ducdung3907/ai-rtl/README.md

# ai-rtl: int8 Systolic Array Matrix Multiplier



A parameterised **N×N output-stationary systolic array** in SystemVerilog that computes **C = A × B** on signed 8-bit inputs with 32-bit accumulators, the core operation of neural-network accelerators such as Google's TPU.

You feed plain matrices one column of A and one row of B per cycle; the hardware skews the inputs, streams them through N² multiply-accumulate units, and raises `done` the cycle the result is ready. Two MAC designs are selectable with one parameter: a single-cycle MAC built from logic, and a two-stage pipelined MAC that maps onto one DSP48E1 per PE.

On an AMD Artix-7 the pipelined array holds **above 220 MHz up to N = 15** (225 PEs, about **99 GOPS** peak) while using **under 150 LUTs**, compared with 114 MHz and 33,371 LUTs for the single-cycle version at N = 16. Everything is verified in simulation for N = 2 to 8 with random data, varying matrix lengths, idle cycles in the input stream and back-to-back matrices, for both MAC designs.

The array runs on an **FPGA board** (QMTech Wukong V3, XC7A100T) in two designs:

- **v2, matrix-multiply server:** a PC sends A and B over USB-UART and gets C back. Measured on the board: every result correct, up to 336 jobs/s with jobs overlapped, and an int8 MNIST network bit-exact on 1,000 images with all its multiply-accumulates on the array.
- **v3, the whole network on the chip:** the weights live in block RAM and the FPGA runs both layers, bias, requantisation, ReLU and argmax; the PC sends 4 images and gets 4 digits back. Measured on the board: 8.9 ms per image (33× faster than v2), every digit identical to the integer reference, 97.20% on the 10,000 test images.

All 44 testbench runs execute on every push through GitHub Actions.

## Block diagram

```mermaid
flowchart LR
    A["a_col<br/>(column of A)"] --> SA["skew_a<br/>row i delayed i cycles"]
    B["b_row<br/>(row of B)"] --> SB["skew_b<br/>column j delayed j cycles"]
    V["valid / start"] --> SA
    V --> SB
    SA -- "a, valid, clear" --> ARR["N×N systolic array<br/>(N² PEs)"]
    SB -- "b, valid" --> ARR
    ARR --> C["acc[i][j] = C[i][j]"]
    L["last"] --> D["delay line<br/>2(N−1) + MAC_LAT cycles"] --> DONE["done"]
```

Inside the array, `a` values move right and `b` values move down, one PE per cycle. Each PE multiplies the pair passing through it and keeps its own running sum:

```
            b[0]       b[1]       b[2]       b[3]
             ▼          ▼          ▼          ▼
a[0] ──►  PE(0,0) ──► PE(0,1) ──► PE(0,2) ──► PE(0,3)
             ▼          ▼          ▼          ▼
a[1] ──►  PE(1,0) ──► PE(1,1) ──► PE(1,2) ──► PE(1,3)
             ▼          ▼          ▼          ▼
a[2] ──►  PE(2,0) ──► PE(2,1) ──► PE(2,2) ──► PE(2,3)
             ▼          ▼          ▼          ▼
a[3] ──►  PE(3,0) ──► PE(3,1) ──► PE(3,2) ──► PE(3,3)

PE(i,j) accumulates C[i][j] = Σk A[i][k] · B[k][j]
```

## Features

- **Parameterised size N** (tested N = 2, 3, 4, 8), built with `generate` loops
- **Two MAC designs, one parameter:** `MAC_LAT = 1` (single-cycle) or `MAC_LAT = 2` (pipelined, one DSP48 per PE); the `done` timing follows automatically
- **Any inner dimension K:** an N×N array computes (N×K) × (K×N) for any K; the 32-bit accumulator has headroom for very long sums
- **Signed int8 × int8 → int32** multiply-accumulate in every PE
- **Hardware input skewing:** the array takes unskewed columns and rows straight from memory
- **Valid signals travel with the data:** idle cycles (bubbles) anywhere in the input are ignored
- **Per-row clear travelling with the data:** matrices can be streamed back to back with no gap
- **`done` signal:** pulses exactly 2(N−1) + MAC_LAT cycles after the last column, on the first cycle all results are final
- **Area-aware registers:** control signals (valid, start, done) have a reset; data registers (skew lanes, forwarded `a` and `b`) do not, since their valid bit marks them as unused

## Top-level interface: `complete_sa`

| Parameter | Default | Description |
| --- | --- | --- |
| `N` | 4 | Array size (N×N PEs) |
| `MAC_LAT` | 2 | MAC latency in cycles: 1 = single-cycle `mac8`, 2 = pipelined `mac8_pipe` |

| Port | Dir | Width | Description |
| --- | --- | --- | --- |
| `clk` | in | 1 | Clock |
| `rst_n` | in | 1 | Reset, active low (hold for at least one clock edge: the pipelined MAC resets synchronously) |
| `a_col` | in | `[N-1:0][7:0]` | Column k of A: `a_col[i] = A[i][k]` |
| `b_row` | in | `[N-1:0][7:0]` | Row k of B: `b_row[j] = B[k][j]` |
| `valid` | in | 1 | This cycle's column/row is real data |
| `start` | in | 1 | First column of a new matrix (starts fresh sums) |
| `last` | in | 1 | Last column of the matrix |
| `done` | out | 1 | One-cycle pulse when every result is final |
| `acc` | out | `[N-1:0][N-1:0][31:0]` | `acc[i][j] = C[i][j]` (signed) |

**Usage:** on each cycle, drive one column of A and the matching row of B with `valid = 1`. Set `start = 1` on the first column and `last = 1` on the last (both on the same cycle if K = 1). Wait for `done`, then read `acc`.

## How it works

**Dataflow (output-stationary).** Each PE keeps one element of C. Row i of A enters from the left and moves right; column j of B enters from the top and moves down. Every PE forwards its inputs to its neighbours through registers, one cycle per hop.

**Skewing.** Data reaching PE(i,j) has passed through j PEs horizontally and i PEs vertically, so the `a` and `b` paths have different delays. To line them up, row i of A enters i cycles late and column j of B enters j cycles late. Both then reach PE(i,j) after i + j cycles, so the k-th product happens on cycle **k + i + j**. The skew module implements this with shift registers: lane i has exactly i registers, N(N−1)/2 per side.

For N = 2, the inputs reaching the array look like this:

| Cycle | Row 0 | Row 1 | Column 0 | Column 1 |
| --- | --- | --- | --- | --- |
| 0 | A00 | – | B00 | – |
| 1 | A01 | A10 | B10 | B01 |
| 2 | – | A11 | – | B11 |

**Valid and clear.** Each value carries a valid bit; a PE only accumulates when both its inputs are valid, so empty slots in the skew pattern and idle cycles in the input are ignored. The `start` signal is skewed into one clear per row and travels right with `a`, so it reaches PE(i,j) exactly when that PE's first product of a new matrix arrives (clear-and-load in one cycle). A single global clear would instead force a pause between matrices.

**Timing.** For a matrix with K columns fed on cycles 0 … K−1:

| Quantity | Value |
| --- | --- |
| `done` after the last column | 2(N−1) + MAC_LAT cycles = (N−1) skew + (N−1) PE hops + MAC latency |
| First column to `done` | K + 2(N−1) + MAC_LAT − 1 cycles |
| Peak throughput | N² multiply-accumulates per cycle (both MAC designs) |

The pipelined MAC adds its extra cycle **once**, not once per PE: `a` and `b` reach the next PE through the PE's forwarding registers, not through the MAC, so the MAC's latency only delays each PE's own result.

## The two MACs

**`mac8` (MAC_LAT = 1):** multiply and accumulate in one cycle. Simple, but the critical path is input register → 8×8 multiplier → 32-bit adder at every array size.

**`mac8_pipe` (MAC_LAT = 2):** two stages, written so Vivado maps the whole MAC into one DSP48E1 (product in the M register, sum in the P register):

1. **Stage 1:** `prod <= a × b`, or **0** when the input is invalid or in reset. `clear1` is the clear delayed by one cycle.
2. **Stage 2:** `acc <= prod` when `clear1` is set, otherwise `acc <= acc + prod`.

Forcing invalid products to zero collapses the four cases (load, clear, add, hold) into two (load or add), since adding 0 is the same as holding. Stage 2 therefore depends on a single register bit, `clear1`, which drives the DSP's OPMODE pin with no logic in between. All resets are synchronous, as the DSP's internal registers require, and `clear1` carries a `keep` attribute so synthesis keeps one copy per PE (see the timing results below).

## Modules

| File | Module | Description |
| --- | --- | --- |
| [`rtl/mac.sv`](rtl/mac.sv) | `mac8`, `mac8_pipe` | Single-cycle MAC, and the two-stage pipelined MAC for DSP48 mapping |
| [`rtl/pe.sv`](rtl/pe.sv) | `pe8` | Processing element: selects the MAC with `MAC_LAT`, plus registers that forward a, b, valid and clear |
| [`rtl/sa2x2.sv`](rtl/sa2x2.sv) | `sa2x2` | 2×2 array wired by hand (first step towards N×N) |
| [`rtl/saNxN.sv`](rtl/saNxN.sv) | `systolic_array` | Parameterised N×N array built with nested `generate` loops |
| [`rtl/skew.sv`](rtl/skew.sv) | `skew` | Input skewing: lane i delayed by i cycles, with valid and start |
| [`rtl/sa_top.sv`](rtl/sa_top.sv) | `complete_sa` | Top level: two skew modules, the array and the `done` delay line |
| [`board/uart_rx.sv`](board/uart_rx.sv) | `uart_rx` | 8N1 receiver: 2-flop synchroniser, mid-bit sampling, false-start and framing-error rejection, 1-clock `valid` |
| [`board/uart_tx.sv`](board/uart_tx.sv) | `uart_tx` | 8N1 transmitter with valid/ready handshake; accepts the next byte in the last stop-bit clock, so frames follow with no gap |
| [`board/sa_ctrl.sv`](board/sa_ctrl.sv) | `sa_ctrl` | Job controller (v2): reads request bytes from the FIFO, feeds `complete_sa` one step per K, hands the result to `res_buf` on `done` |
| [`board/sync_fifo.sv`](board/sync_fifo.sv) | `sync_fifo` | First-word-fall-through byte FIFO between `uart_rx` and `sa_ctrl`, with a sticky overflow flag |
| [`board/res_buf.sv`](board/res_buf.sv) | `res_buf` | Result buffer: captures `acc`, then streams the N×N int32 bytes to `uart_tx` while the next job already computes |
| [`board/sa_board_top.sv`](board/sa_board_top.sv) | `sa_board_top` | Board top: reset synchroniser, UART, FIFO, `sa_ctrl`, `complete_sa`, `res_buf`, heartbeat and job LEDs (`led[0]` solid = FIFO overflow) |
| [`board/frame_rx.sv`](board/frame_rx.sv) | `frame_rx` | v3 frame parser: START, seq, 3,136 pixel bytes, checksum; writes 4 bytes per word into the input RAM, pulses `frame_ok` / `frame_err`, resyncs on any top-bit byte |
| [`board/infer_core.sv`](board/infer_core.sv) | `infer_core` | v3 controller and datapath: input, hidden and weight memories, `complete_sa`, 4 requant lanes, 4 argmax units; runs both layers tile by tile |
| [`board/requant.sv`](board/requant.sv) | `requant` | Bias add, fixed-point scale (`× M >> shift`, rounded) and clip to 0..127 (the ReLU); 3-stage pipeline |
| [`board/argmax.sv`](board/argmax.sv) | `argmax` | Index of the largest of `WIDTH` values streamed one per cycle; the first maximum wins a tie |
| [`board/simple_dp_ram.sv`](board/simple_dp_ram.sv) | `simple_dp_ram` | One write port and one read port, 1-cycle read (block RAM) |
| [`board/weight_rom.sv`](board/weight_rom.sv) | `weight_rom` | Block-RAM ROM loaded from a `.mem` file (weights, biases) |
| [`board/reply_tx.sv`](board/reply_tx.sv) | `reply_tx` | v3 reply: `[A6][seq][4 digits]` or `[E6][seq]` on a checksum error, one byte at a time to `uart_tx` |
| [`board/infer_board_top.sv`](board/infer_board_top.sv) | `infer_board_top` | v3 board top: `uart_rx → frame_rx → infer_core → reply_tx → uart_tx`; same pins as `sa_board_top` |
| [`board/board_top.sv`](board/board_top.sv) | `board_top` | Bring-up design: UART echo with a pending flag, heartbeat and byte LEDs |
| [`board/wukong.xdc`](board/wukong.xdc), [`board/wukong_impl.xdc`](board/wukong_impl.xdc) | | Pin and clock constraints from the QMTECH Wukong V3 schematic (the second file is implementation-only) |
| [`host/run_jobs.py`](host/run_jobs.py) | | Python host: echo test, single job, 1,000-job run with throughput report, and a software model of the board |
| [`host/infer_frame.py`](host/infer_frame.py) | | v3 frame protocol: builds frames, parses replies, and a byte-level software model of the board (`FakeInferBoard`) |

## Verification

Every testbench is self-checking: it computes the expected result with a reference model in the testbench and prints PASS or FAIL. `sim/run_all.sh` runs all of them across sizes and settings (44 runs) and fails if any run fails; GitHub Actions runs it on every push. Results with Icarus Verilog 12 (local and CI); also checked with 14.0 devel:

| Testbench | Covers | Result |
| --- | --- | --- |
| [`tb/tb_mac.sv`](tb/tb_mac.sv) | Both MACs against one reference model: reset with inputs active, 13 directed cases, 20,000 weighted-random cycles, coverage counters | PASS (20,018 checks) |
| [`tb/tb_pe.sv`](tb/tb_pe.sv) | Reset, forwarding, valid gating, directed cases, 20,000 random cycles; reference model delayed by the MAC latency | PASS for MAC_LAT = 1 and 2 (20,014 / 20,015 checks) |
| [`tb/tb_sa2x2.sv`](tb/tb_sa2x2.sv) | 6 directed matrices + 1,000 random, skew done in the testbench | PASS (1,006 multiplications) |
| [`tb/tb_asNxN.sv`](tb/tb_asNxN.sv) | Identity, K = 1, extreme values, back-to-back, 500 random with varying K | PASS at N = 2, 3, 4, 8 (555 multiplications each) |
| [`tb/tb_skew.sv`](tb/tb_skew.sv) | Input-history model; reset with inputs active, impulse, counting pattern, all-bits toggle, 2,000 random cycles | PASS at N = 1 to 64 (32,737 checks at N = 8) |
| [`tb/tb_sa_top.sv`](tb/tb_sa_top.sv) | Full chain from unskewed input: directed, bubbles with junk data, back-to-back, 500 random; exact `done` timing | PASS at N = 2, 3, 4, 8 for MAC_LAT = 1 and 2 (605 multiplications each) |
| [`tb/tb_uart_tx.sv`](tb/tb_uart_tx.sv) | Receiver model and queue scoreboard; every bit exactly one bit time, `ready` timing, back-to-back frames | PASS (316 bytes) |
| [`tb/tb_uart_rx.sv`](tb/tb_uart_rx.sv) | Asynchronous sender at ±2.5% baud error, glitches, bad stop bits, back-to-back, random gaps | PASS (238 bytes; glitches and bad frames ignored) |
| [`tb/tb_board_top.sv`](tb/tb_board_top.sv) | Echo through the pins, continuous streams with the PC 0.5% fast and slow, LEDs | PASS (53 bytes each) |
| [`tb/tb_sa_ctrl.sv`](tb/tb_sa_ctrl.sv) | Controller with the real `complete_sa`: K = 0, 1, N, 7, 256 and random, junk before the header, `tx_ready` backpressure, bytes during compute ignored | PASS at N = 2, 4, 8 for MAC_LAT = 1 and 2 (25 jobs each) |
| [`tb/tb_sa_board_top.sv`](tb/tb_sa_board_top.sv) | Whole board path: a PC model sends jobs bit by bit into the `uart_rx` pin and checks C from the `uart_tx` pin | PASS (12 jobs; also at PC baud ±0.5%) |
| [`tb/tb_requant.sv`](tb/tb_requant.sv) | 5,614 vectors from [`tb/gen_requant_vectors.py`](tb/gen_requant_vectors.py): rounding, negative sums (ReLU), saturation, back to back | PASS |
| [`tb/tb_argmax.sv`](tb/tb_argmax.sv) | Directed, random, ties (first maximum), gaps, junk while `in_valid` is low; exact 1-cycle timing | PASS for WIDTH = 10 and 4 (1,510 vectors) |
| [`tb/tb_simple_dp_ram.sv`](tb/tb_simple_dp_ram.sv), [`tb/tb_weight_rom.sv`](tb/tb_weight_rom.sv) | 1-cycle read, read-first on a same-address write, write enable; ROM contents against `ml/mem/weights.mem` | PASS |
| [`tb/tb_frame_rx.sv`](tb/tb_frame_rx.sv) | Good frames, bad checksums (every checksum bit), dropped and extra bytes, stray START, truncated frames, 60 fuzzed frames | PASS at N_STEPS = 784 and 16 |
| [`tb/tb_infer_core.sv`](tb/tb_infer_core.sv) | 15 batches (60 images) from [`tb/gen_infer_vectors.py`](tb/gen_infer_vectors.py): digits, all 64 hidden words, `done_seq`, one `done` pulse, `busy`, a second `start` ignored | PASS (12,991 cycles per batch) |
| [`tb/tb_reply_tx.sv`](tb/tb_reply_tx.sv) | Random done/error events, both at once, events during a reply, `tx_ready` 100/50/10% | PASS |
| [`tb/tb_infer_board_top.sv`](tb/tb_infer_board_top.sv) | v3 through the UART pins: junk, good frames, bad checksum, cut frames, seq 0 and 127, LEDs | PASS (6 replies) |

Each testbench was also checked against deliberately broken designs (wrong wiring, missing reset, misaligned valid, clear not travelling with the data, `done` one cycle late, and for the pipelined MAC: using `clear` instead of `clear1`, a stuck valid, a product register without reset) to make sure it catches real bugs.

## Running the tests

Requires [Icarus Verilog](https://steveicarus.github.io/iverilog/) 12 or newer. From the repository root, run everything (runs in parallel, `JOBS=1` for one at a time; the two v3 system runs take about 1 and 4 minutes on their own):

```bash
./sim/run_all.sh            # all 44 runs, exits 1 if any fails
./sim/run_all.sh sa_ctrl    # only runs whose name contains "sa_ctrl"
```

Or single testbenches:

```bash
# Full system (skew + array + done), pipelined MAC
iverilog -g2012 -Ptb_complete_sa.MAC_LAT=2 -o sim.vvp rtl/mac.sv rtl/pe.sv rtl/saNxN.sv rtl/skew.sv rtl/sa_top.sv tb/tb_sa_top.sv
vvp sim.vvp

# Individual blocks
iverilog -g2012 -o sim.vvp rtl/mac.sv tb/tb_mac.sv && vvp sim.vvp
iverilog -g2012 -Ptb_pe8.MAC_LAT=2 -o sim.vvp rtl/mac.sv rtl/pe.sv tb/tb_pe.sv && vvp sim.vvp
iverilog -g2012 -o sim.vvp rtl/mac.sv rtl/pe.sv rtl/sa2x2.sv tb/tb_sa2x2.sv && vvp sim.vvp
iverilog -g2012 -o sim.vvp rtl/mac.sv rtl/pe.sv rtl/saNxN.sv tb/tb_asNxN.sv && vvp sim.vvp
iverilog -g2012 -o sim.vvp rtl/skew.sv tb/tb_skew.sv && vvp sim.vvp
```

Other sizes, MAC designs and random seeds:

```bash
iverilog -g2012 -Ptb_complete_sa.N=8 -Ptb_complete_sa.MAC_LAT=1 -o sim.vvp rtl/*.sv tb/tb_sa_top.sv
vvp sim.vvp +seed=42
```

## On the board: UART host interface

```
PC ──USB── CH340 ──> uart_rx ──> sync_fifo ──> sa_ctrl ──> complete_sa ──> res_buf ──> uart_tx ──> CH340 ──> PC
```

**Protocol (PC → FPGA):** header `0xA5`, then K (number of steps, 2 bytes little-endian, 1 to 65,535; K = 0 means no job), then K steps of 2N bytes: column k of A followed by row k of B, signed int8. **Reply:** the N×N results row by row, each a little-endian int32 (64 bytes at N = 4). `res_buf` takes the snapshot of `acc` once the array is done, so the reply is correct even while the next request streams in.

**Board:** QMTECH Wukong V3 (XC7A100T-1FGG676C, 50 MHz oscillator, CH340 USB-UART). Pins and the configuration-bank settings come from the V3 schematic; the 50 MHz clock arrives on a non-clock-capable pin, which `wukong_impl.xdc` allows. The echo design uses 79 LUTs and 86 flip-flops (matching a hand count of every register) and meets timing at 50 MHz with 15.7 ns of slack.

**Host script:**

```bash
python host/run_jobs.py --mode echo --port COM5                 # with the board_top (echo) bitstream
python host/run_jobs.py --mode job  --port COM5 --N 4 --K 16    # one job, compared with NumPy
python host/run_jobs.py --mode run  --port COM5 --jobs 1000     # 1,000 random jobs, jobs/s and throughput
python host/run_jobs.py --mode run  --port fake                 # no board: software model of sa_ctrl
```

**Expected throughput:** 1,000 jobs with K up to 64 move about 325 KB. At 115,200 baud the UART carries at most 11,520 bytes/s, so the run takes at least about 28 s (about 35 jobs/s), while the array computes each job in about a microsecond. The link, not the array, sets the speed.

**Measured on the Wukong board** (N = 4, MAC_LAT = 2, 50 MHz, random jobs checked against NumPy):

| Baud | Jobs | Result | Jobs/s | Throughput | Share of link limit |
| --- | --- | --- | --- | --- | --- |
| 115,200 | 1,000 (K ≤ 64) | 1000/1000 correct | 34.6 | 11,242 B/s | 97.6% |
| 1,000,000 | 1,000 (K ≤ 64) | 1000/1000 correct | 236.3 | 76,809 B/s | 76.8% |
| 1,000,000 | 100 (K ≤ 1000) | 100/100 correct | 21.2 | 88,535 B/s | 88.5% |
| 2,000,000 | — | replies lose one byte near byte 35 | — | — | — |

The array computes a job in about a microsecond; all of the time is data movement.

- **Where the 1 Mbaud overhead goes:** about 9% is idle gaps the CH340 USB-UART bridge leaves in the
  PC → FPGA stream (sending is ~10% slower than the ideal wire time), and about 0.6 ms per job is USB
  round-trip latency on the reply. Host-side Python adds under 1% (preparing all jobs in advance
  changed throughput by less than 1%).
- **2 Mbaud:** the FPGA receives correctly, but continuous 2 Mbaud replies overflow the CH340's
  internal buffer after about 32 bytes, so **1 Mbaud is the default**.
- **Echo stream limit:** the CH340 runs ~0.3% fast, so a continuous echo of more than ~280 bytes
  eventually drops a byte (the transmitter cannot outpace a faster sender forever). Request/reply
  jobs are not affected.

### Pipelined v2 on the board

The v2 bitstream (UART → FIFO → controller → array → result buffer → UART) built in Vivado 2025.2 for `xc7a100tfgg676-1` at 50 MHz: 681 LUTs, 192 LUTRAM, 936 flip-flops, 16 DSPs, WNS +11.730 ns, WHS +0.049 ns, 0.111 W (estimated). Same random jobs as above, N = 4, 1 Mbaud, every result checked against NumPy; `--window W` keeps W jobs in flight:

| Run | Jobs | Result | Jobs/s | Throughput |
| --- | --- | --- | --- | --- |
| window 1, K ≤ 64 | 1,000 | 1000/1000 correct | 236.6 | 76,900 B/s |
| window 2, K ≤ 64 | 1,000 | 1000/1000 correct | 330.3 (+40%) | 107,354 B/s |
| window 3, K ≤ 64 | 1,000 | 1000/1000 correct | 336.4 (+42%) | 109,359 B/s |
| window 2, K ≤ 1000 | 100 | 100/100 correct | 21.55 | 89,978 B/s |

- **The overlap works:** with window ≥ 2 the next request streams in while the previous reply goes out, so the combined rate passes the 100 KB/s single-direction limit (UART is full duplex).
- **What limits it now:** the PC → FPGA direction. A job averages 261 request bytes, so at most about 383 jobs/s; window 3 reaches about 88% of that. The remainder is the idle time the CH340 leaves between bytes.
- **Large K gains little:** a K = 500 job is about 4 KB in and 64 bytes out, so there is almost no reply to hide.
- **Window 1 is unchanged from v1** (236.6 vs 236.3 jobs/s), so the extra FIFO and buffer cost nothing when unused.
- **On-chip MNIST:** [`ml/`](ml/) runs an int8 MLP with all multiply-accumulates on the array; 1,000 validation images are bit-exact against the integer reference.

### v3: the whole network on the FPGA

In v2 the weights crossed the UART on every job and the PC did everything except the multiplies (294 ms per image). v3 keeps the weights in block RAM and runs the whole 784 → 64 → 10 network on the chip. The PC sends 4 images and reads back 4 digits.

```mermaid
flowchart LR
    RX["uart_rx"] --> FR["frame_rx<br/>parse, checksum"]
    FR --> IN["input RAM<br/>784 × 32"]
    IN --> MUX{"a_col mux"}
    HID["hidden RAM<br/>64 × 32"] -- "pass 2" --> MUX
    ROM["weight ROM<br/>12,736 × 32"] --> SA["complete_sa<br/>4×4 array"]
    MUX --> SA
    SA -- "pass 1" --> RQ["+bias1, requant ×4<br/>(ReLU)"] --> HID
    SA -- "pass 2" --> AM["+bias2, argmax ×4"] --> RP["reply_tx"] --> TX["uart_tx"]
    FR -- "frame_err" --> RP
```

**How it works.** One array runs both layers. A tile is 4 neurons (the array's 4 columns) for 4 images (its 4 rows): layer 1 is 16 tiles of 784 steps, layer 2 is 3 tiles of 64 steps (10 outputs padded to 12; the 2 padding neurons never reach the argmax). After each tile, the epilogue adds the bias to one column per cycle and either requantises it into the hidden RAM (layer 1) or feeds it to the argmax units (layer 2). Pass 2 reads the hidden RAM exactly the way pass 1 reads the input RAM. Every memory word holds 4 int8 values, one per image or one per weight column, so one read feeds all 4 lanes. One batch takes 12,991 cycles (0.26 ms at 50 MHz).

**Protocol.** PC → FPGA: `[0xA6][seq][3,136 pixel bytes][checksum]`, pixels 0..127 in step order (pixel k of images 0..3, then pixel k + 1), checksum = sum of the pixel bytes mod 128. FPGA → PC: `[0xA6][seq][d0][d1][d2][d3]`, or `[0xE6][seq]` on a checksum error. Only START has its top bit set, so a dropped or extra byte abandons that frame and the next START resyncs. The host waits for each reply before the next frame (layer 1 re-reads the input RAM on every tile).

**Weights.** [`ml/gen_mem.py`](ml/gen_mem.py) turns `mlp_64_int8.npz` into `ml/mem/weights.mem`, `bias1.mem`, `bias2.mem` and `model_params.svh` (M, shift, tile counts). In Vivado, add those four files to the project (the `.svh` as a Verilog Header).

**Vivado 2025.2 (`infer_board_top`, xc7a100tfgg676-1, 50 MHz):** 780 LUTs (all logic, no LUTRAM; v2 used 192 for its FIFO), 852 flip-flops, 24 DSPs (16 for the array, 2 per requant lane), 17.5 block RAM tiles (about 13 of them the weight ROM), WNS +12.256 ns, WHS +0.035 ns, 0.124 W (estimated). The design fills about 1% of the chip.

| Block | LUTs | Flip-flops | Block RAM | DSPs |
| --- | --- | --- | --- | --- |
| `infer_core` (controller, array, requant, argmax, memories) | 627 | 634 | 17.5 | 24 |
| `frame_rx` | 44 | 104 | 0 | 0 |
| UARTs, `reply_tx`, LEDs, reset | 109 | 114 | 0 | 0 |
| **Total** | **780** | **852** | **17.5** | **24** |

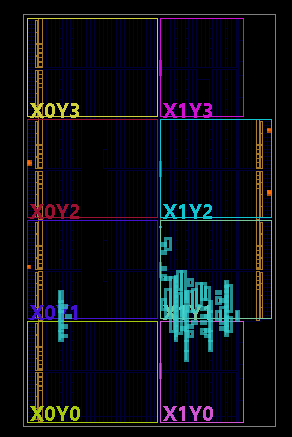
[picture p1: docs/vivado_v3_device.png]
Placed v3 design on the XC7A100T: everything sits in one corner of the chip


**Measured on the board** (`python ml/board_infer.py --onchip --port COM6`):

| Run | Images | Digits equal to `ref_infer` | Accuracy | ms per image | Images/s |
| --- | --- | --- | --- | --- | --- |
| validation | 1,000 | 1,000 of 1,000 | 97.60% | 8.91 | 112.3 |
| test | 10,000 | 10,000 of 10,000 | 97.20% | 8.90 | 112.4 |

- **Speed-up over v2:** 33× (294 ms per image in v2). 2,750 frames ran with no checksum errors or retries.
- **Traffic:** about 785 bytes per image in and 1.5 out, against 25.8 KB per image in v2.
- **The UART still sets the speed.** A frame is 3,139 bytes, so 1 Mbaud allows at best 31.4 ms per frame (7.85 ms per image). Measured: 35.6 ms per frame, 88% of that limit. The rest is the idle gaps the CH340 leaves between bytes (about 3 ms) and the USB round trip of each reply (about 1 ms); the FPGA computes a frame in 0.26 ms.
- **Against a PC:** the same network in NumPy takes about 46 µs per image (integer maths) or 1.5 µs (float32 BLAS), batched, on a 2-core cloud machine. The FPGA computes in 65 µs per image with 16 PEs at 50 MHz, using about 1% of the chip; the link, not the array, makes it slower end to end.

```
$ python ml/board_infer.py --onchip --port COM6 --n 1000
1000 images in 8.91 s: 8.91 ms/image, 112.3 images/s (250 frames, 0 retries)
UART: 784750 bytes out, 1500 bytes in (785 + 1.5 bytes/image)
board accuracy on these 1000 images: 97.60%
all 1000 digits identical to ref_infer

$ python ml/board_infer.py --onchip --port COM6 --test
10000 images in 88.97 s: 8.90 ms/image, 112.4 images/s (2500 frames, 0 retries)
UART: 7847500 bytes out, 15000 bytes in (785 + 1.5 bytes/image)
board accuracy on these 10000 images: 97.20%
all 10000 digits identical to ref_infer
```

**Drawing demo.** [`ml/draw_demo.py`](ml/draw_demo.py) lets you draw a digit with the mouse; it is turned into a 28×28 MNIST-style image and sent to the board as a frame, and the board's digit is shown next to the PC's reference scores (one answer in about 35 ms). The board and the PC agreed on every drawing; the model itself misreads some hand-drawn styles, since it is a small MLP trained only on MNIST. In the screenshot, a 9 with a curled loop is read as 3 by both.

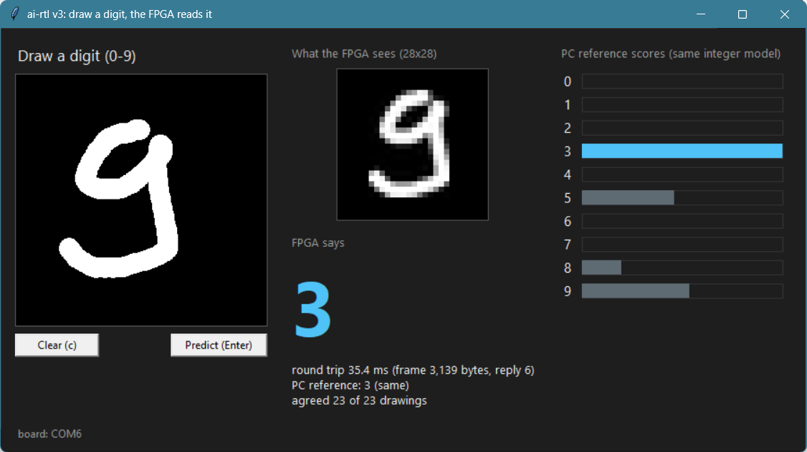
[picture p2: docs/v3_demo.png]
Drawing demo on the board: a curled 9 read as 3, the same answer as the PC's reference, 35 ms round trip


## Synthesis results

The same RTL was synthesised, placed and routed for two FPGAs with two toolflows: **AMD Artix-7** with **Vivado**, and **Lattice ECP5** with the open-source **sv2v + Yosys + nextpnr** flow. Max clock comes from static timing analysis after place and route. Peak throughput = 2 operations (multiply + add) × N² PEs × max clock.

**Summary (Artix-7 XC7A100T):**

| N | PEs | Single-cycle MAC (LUTs) | Pipelined MAC (DSP48) |
| --- | --- | --- | --- |
| 2 | 4 | 530 LUTs, 128 MHz, 1.0 GOPS | 6 LUTs + 4 DSPs, 297 MHz, 2.4 GOPS |
| 4 | 16 | 2,098 LUTs, 122 MHz, 3.9 GOPS | 11 LUTs + 16 DSPs, 282 MHz, 9.0 GOPS |
| 8 | 64 | 8,424 LUTs, 121 MHz, 15.5 GOPS | 47 LUTs + 64 DSPs, 256 MHz, 32.8 GOPS |
| 12 | 144 | 18,821 LUTs, 117 MHz, 33.7 GOPS | 102 LUTs + 144 DSPs, 233 MHz, 67.0 GOPS |
| 15 | 225 | – | 147 LUTs + 225 DSPs, 221 MHz, 99.4 GOPS |
| 16 | 256 | 33,371 LUTs, 114 MHz, 58.3 GOPS | 1,685 LUTs + 240 DSPs, 189 MHz, 96.8 GOPS |

### AMD Artix-7 (Vivado)

Target: **XC7A100T-1CSG324** (63,400 LUTs, 126,800 flip-flops, 240 DSP48E1 slices), the FPGA on the Nexys A7-100T and Arty A7-100T boards. `complete_sa` was synthesised out of context (`-mode out_of_context`, so its ports need no FPGA pins) with Vivado's default synthesis and implementation strategies and a 5 ns clock constraint ([`synth/timing.xdc`](synth/timing.xdc)); the maximum clock is 1 / (5 ns − WNS).

#### Single-cycle MAC (`MAC_LAT = 1`, LUT multipliers)

| N | PEs | LUTs | % of chip | LUTRAM | Flip-flops | DSPs | WNS at 5 ns | Max clock | Power (est.) |
| --- | --- | --- | --- | --- | --- | --- | --- | --- | --- |
| 2 | 4 | 530 | 0.8% | 0 | 185 | 0 | −2.798 ns | 128 MHz | – |
| 4 | 16 | 2,098 | 3.3% | 0 | 820 | 0 | −3.205 ns | 122 MHz | – |
| 8 | 64 | 8,424 | 13% | 32 | 3,265 | 0 | −3.288 ns | 121 MHz | 0.36 W |
| 12 | 144 | 18,821 | 30% | 64 | 7,328 | 0 | −3.544 ns | 117 MHz | 0.71 W |
| 16 | 256 | 33,371 | 53% | 96 | 13,069 | 0 | −3.781 ns | 114 MHz | 1.16 W |

*These runs used the RTL before the `MAC_LAT` refactor; N = 2 was re-run with the current code and gave the same LUT count and clock (530 LUTs, WNS −2.800 ns). With its default settings Vivado builds the 8×8 multipliers from LUTs and carry chains rather than DSP48 slices. Power is Vivado's vectorless estimate at the 5 ns constraint (medium confidence), not a measurement.*

- **Area scales linearly with the number of PEs:** about 125 LUTs per PE, so the size of any array can be predicted before synthesis.
- **The clock barely drops as the array grows:** 128 → 114 MHz (−11%) while the array grows 64×. Every PE only connects to its neighbours, and LUT-based multipliers can sit right next to their PE.
- **The critical path is the single-cycle MAC:** at N = 16 the worst path runs from one PE's `b` forwarding register through the multiplier and the 32-bit adder into the next PE's accumulator. The high accumulator bits are last because the carry ripples up the adder.
- **Unreset delay lines become LUT shift registers:** from N = 8, Vivado packs the longer skew lanes into SRLs, which is why LUTRAM appears. This only works because the skew data registers have no reset.
- **Forcing DSPs on the single-cycle MAC does not help:** with `(* use_dsp = "yes" *)` at N = 2 it uses 202 LUTs, 59 flip-flops and 8 DSPs (two per PE) but runs at only 119 MHz, because multiply and accumulate cannot share one DSP in a single cycle. This motivated the pipelined MAC.

#### Pipelined MAC (`MAC_LAT = 2`, one DSP48E1 per PE)

The pipelined MAC was improved in two steps, each guided by the timing report:

| N | PEs | First version | + zeroed products (OPMODE fix) | + `keep` on `clear1` (final) | Total gain |
| --- | --- | --- | --- | --- | --- |
| 2 | 4 | 226.9 MHz | 285.3 MHz | **297.0 MHz** | +31% |
| 4 | 16 | 223.5 MHz | 265.0 MHz | **281.7 MHz** | +26% |
| 8 | 64 | 215.4 MHz | 231.3 MHz | **256.0 MHz** | +19% |
| 12 | 144 | 203.7 MHz | 221.6 MHz | **232.8 MHz** | +14% |
| 15 | 225 | 202.6 MHz | 218.0 MHz | **220.9 MHz** | +9% |
| 16 | 256 | 192.6 MHz | 193.0 MHz | 189.0 MHz | – (limited by LUT-built MACs) |

Final version in detail:

| N | PEs | LUTs | LUTRAM | Flip-flops | DSPs | WNS at 5 ns | Max clock | Peak throughput | Power (est.) |
| --- | --- | --- | --- | --- | --- | --- | --- | --- | --- |
| 2 | 4 | 6 | 0 | 12 | 4 | +1.633 ns | 297.0 MHz | 2.4 GOPS | 0.09 W |
| 4 | 16 | 11 | 0 | 196 | 16 | +1.450 ns | 281.7 MHz | 9.0 GOPS | 0.12 W |
| 8 | 64 | 47 | 24 | 1,052 | 64 | +1.094 ns | 256.0 MHz | 32.8 GOPS | 0.24 W |
| 12 | 144 | 102 | 56 | 2,436 | 144 | +0.704 ns | 232.8 MHz | 67.0 GOPS | 0.43 W |
| 15 | 225 | 147 | 80 | 3,831 | 225 | +0.473 ns | 220.9 MHz | 99.4 GOPS | 0.63 W |
| 16 | 256 | 1,685 | 88 | 5,400 | 240 | −0.290 ns | 189.0 MHz | 96.8 GOPS | 0.71 W |

*Vivado 2026.1, same settings as above. Results per step: [`results_vivado_mac2_before.csv`](synth/results_vivado_mac2_before.csv), [`results_vivado_mac2_opmodefix.csv`](synth/results_vivado_mac2_opmodefix.csv), [`results_vivado_mac2_keep.csv`](synth/results_vivado_mac2_keep.csv).*

- **About 20× fewer LUTs and roughly twice the clock** of the single-cycle design at every size. Nearly everything lives inside the DSPs, including the multiplier inputs' registers.
- **First version: the DSP's OPMODE pin was the bottleneck.** Every critical path had the same shape: a control register → one LUT → the DSP48E1's OPMODE input, whose setup time (about 2.4 ns) used half the 5 ns cycle. The LUT combined `clear1` and `valid1` to choose between load, clear, add and hold.
- **Step 1, zeroing invalid products:** with only `clear1` left, the LUT disappeared (0 logic levels) and the polarity inversion moved into the DSP (`IS_INVERTED`). +26% at N = 2.
- **Step 2, stopping register merging:** every PE on a diagonal receives the same `start` at the same moment, so their `clear1` registers hold identical values, and Vivado merged them into one register per diagonal. At N = 15 one register drove 11 DSPs with 1.8 ns of wire. A `keep` attribute gives each PE its own copy: up to +11% more. The flip-flop counts match the predicted N² − (2N − 1) extra registers exactly for N = 2 to 12 (1, 9, 49, 121).
- **The DSP count sets the size limit:** N = 15 (225 of 240 DSPs) is the largest all-DSP array. At N = 16 Vivado builds the remaining 16 MACs from LUTs (+1,500 LUTs) and the clock drops below 200 MHz.
- **The 5 ns constraint understates small arrays:** where the slack is large Vivado stops optimising, so the true maximum at small N is higher. A one-off 3 ns run of the first version at N = 2 reached 278 MHz against 227 MHz from the 5 ns run.

Elaborated RTL schematic of `complete_sa` (N = 2) and the placed single-cycle N = 16 design on the chip:

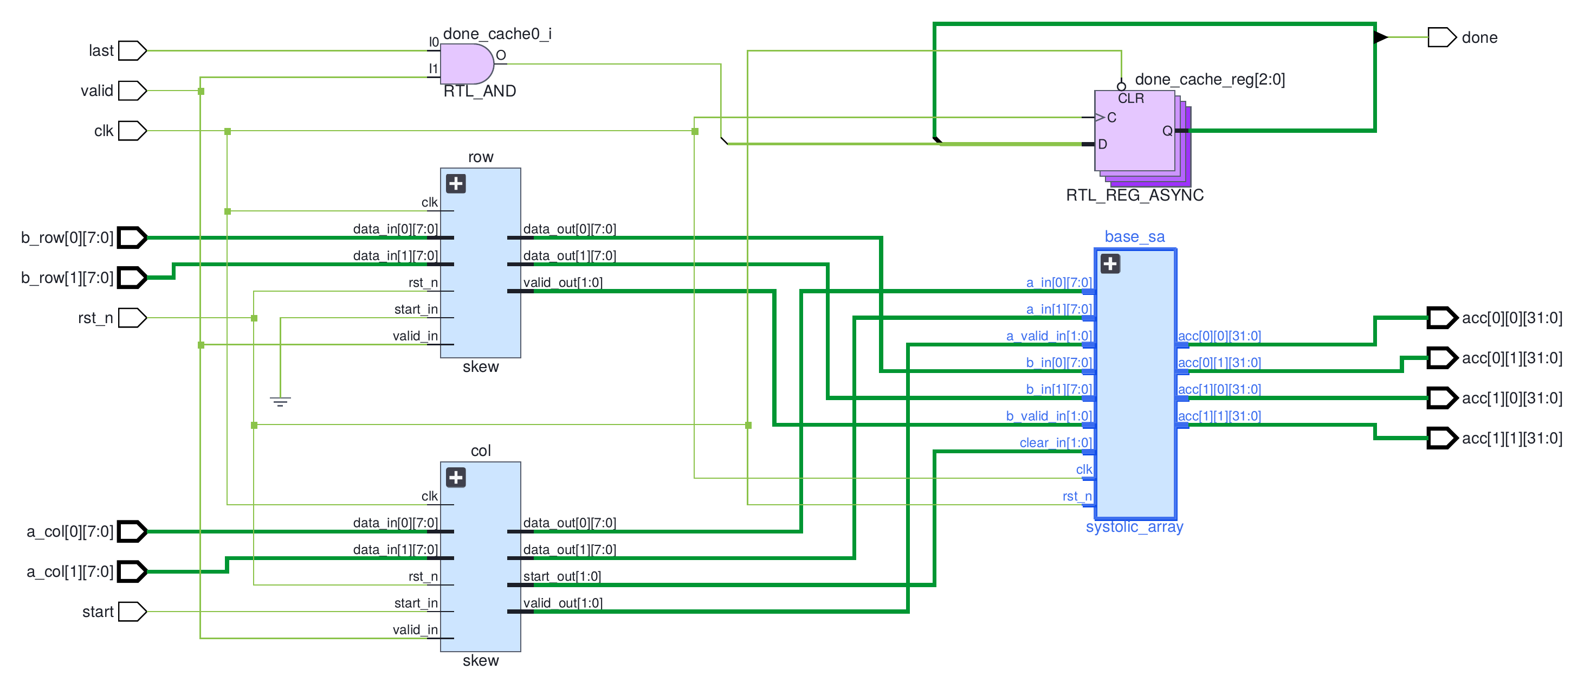
[picture p3: docs/vivado_rtl_schematic_N2.png]
Vivado RTL schematic, N = 2


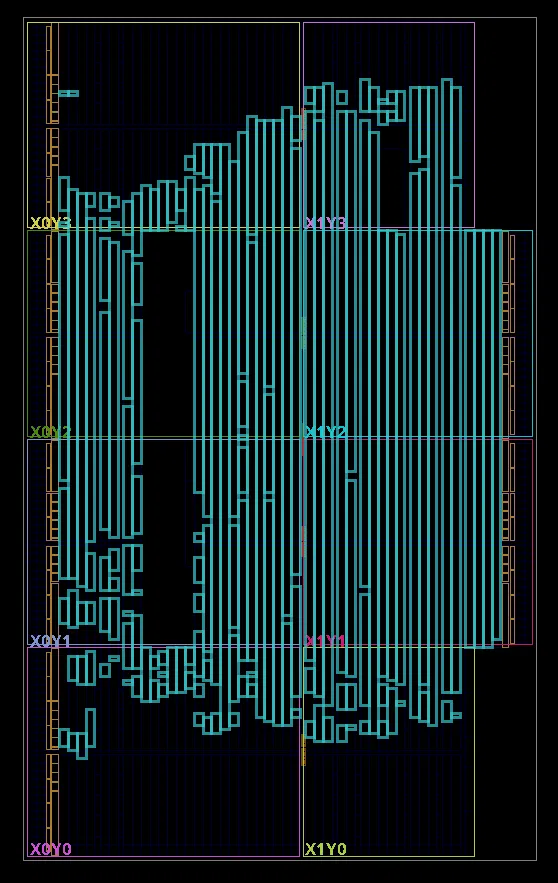
[picture p4: docs/vivado_device_N16.png]
Placed design on the XC7A100T, N = 16


### Lattice ECP5 (open-source flow)

Target: **Lattice ECP5 LFE5U-85F** (83,640 LUTs, 156 hardware 18×18 multipliers). SystemVerilog is converted to Verilog with sv2v, synthesised with Yosys and placed and routed with nextpnr (default router, `--seed 1`, 200 MHz target).

| N | PEs | Max clock: single-cycle | Max clock: pipelined | Speed-up | ECP5 LUTs (both) | ECP5 FFs: single-cycle → pipelined | Multipliers |
| --- | --- | --- | --- | --- | --- | --- | --- |
| 2 | 4 | 96.3 MHz | 139.9 MHz | +45% | 375 | 265 → 336 | 4 |
| 4 | 16 | 82.9 MHz | 117.4 MHz | +42% | 1,259 | 761 → 1,033 | 16 |
| 8 | 64 | 61.5 MHz | 93.4 MHz | +52% | 5,235 | 2,521 → 3,577 | 64 |
| 12 | 144 | 48.3 MHz | did not route | – | 11,483 | 5,305 → – | 144 |

*Results: [`results_mac1.csv`](synth/results_mac1.csv), [`results_mac2.csv`](synth/results_mac2.csv). The pipelined ECP5 numbers were measured with the first version of `mac8_pipe`; the later changes target Vivado's DSP48 mapping. Tools: Yosys and nextpnr-ecp5 0.9 from OSS CAD Suite; other versions and settings give different numbers.*

- **Pipelining is free in LUTs on the ECP5 too:** LUT counts match to within one; the cost is about 17 flip-flops per PE (the 16-bit product register plus a control bit).
- **The clock still falls with N for both designs**, because every PE must reach a hard multiplier in a fixed column, and those wires get longer in bigger arrays.
- **N = 12 fits but the pipelined version does not route:** with 144 of 156 multipliers in use, both nextpnr routers stopped converging (router1 after 2 hours, router2 with overused wires rising after iteration 28). The product registers add traffic around the crowded multiplier columns, where on the Artix-7 they sit inside each DSP48.
- **Tool settings matter:** nextpnr's router2 gave 8–10% lower max clock than the default router on this design, so both MAC designs are compared with the same router.

**Measurement harness.** The array has 2N×8 input and N²×32 output bits (2,048 at N = 8), far more than the FPGA's pins, and synthesis deletes any logic whose output is unused. [`synth/synth_wrap.sv`](synth/synth_wrap.sv) therefore loads the inputs from a one-pin shift register and XOR-folds all results into one 32-bit output over two register stages, so every PE is kept and the harness never limits the clock.

### Cross-tool findings

- **Hard blocks are fast only when their internal registers are used.** The single-cycle MAC was slower with DSPs than with LUTs on the Artix-7; the pipelined MAC, written to match the DSP48's register structure, doubled the clock.
- **Where the pipeline register lives matters:** inside the DSP48 on the Artix-7 it costs nothing and routes easily; in the fabric next to the ECP5's fixed multiplier columns it adds routing pressure, enough to stop N = 12 routing.
- **Synthesis optimisations can work against timing:** merging identical registers saves area but created high-fan-out nets; reading the timing path identified it and one attribute fixed it.

## Reproducing the results

**ECP5 (open-source, Linux or WSL):**

```bash
MAC_LAT=1 ./synth/synth.sh 2 4 8 12   # writes synth/results_mac1.csv
MAC_LAT=2 ./synth/synth.sh 2 4 8      # writes synth/results_mac2.csv
```

Requires [sv2v](https://github.com/zachjs/sv2v), [Yosys](https://github.com/YosysHQ/yosys) and [nextpnr-ecp5](https://github.com/YosysHQ/nextpnr), all available in [OSS CAD Suite](https://github.com/YosysHQ/oss-cad-suite-build). Larger sizes take much longer, mostly in place and route.

**Artix-7 (Vivado):** open a project with the files in `rtl/`, `complete_sa` as top, part `xc7a100tcsg324-1`, out-of-context synthesis and `synth/timing.xdc`. Then in the Tcl Console:

```tcl
source synth/vivado_sweep_gui.tcl
```

It sets `N` and `MAC_LAT` for each run (edit the lists at the top of the script), runs synthesis and implementation, and appends one row per size to `synth/results_vivado_mac<L>.csv`.

## Repository layout

```
rtl/      array design files
board/    UART, v2 job controller, v3 inference core, board tops and Wukong V3 constraints
host/     Python host scripts (run_jobs.py, manual.py, diag2m.py); `--port fake` runs without a board
ml/       int8 MNIST MLP: training, quantisation, reference and on-board inference (v2 and v3)
ml/mem/   weights and biases as .mem files for the v3 ROMs (generated by ml/gen_mem.py)
tb/       self-checking testbenches; tb/vectors/ holds generated test vectors
sim/      run_all.sh: every testbench across sizes and settings
synth/    synthesis: Yosys/nextpnr script and harness, Vivado sweep script, timing constraint, results (CSV)
docs/     figures (Vivado schematic, placed designs for the array sweep and v3, the drawing demo)
.github/  GitHub Actions workflow running sim/run_all.sh
```

## Limitations and next steps

- **Results are only all present between matrices.** In back-to-back streaming, early PEs start the next matrix before the last PE finishes, so `done` assumes a gap before the next `start`. `sa_ctrl` handles this by handing `acc` to `res_buf` on `done` and waiting for `res_buf` to be free before the next job's result, so compute and reply overlap (host `--window 2` or more; measured +42% on the board at window 3).
- **N² × 32 output wires.** Fine for small N, impractical for large arrays. Next step: shift results out one row per cycle.
- **Large-N clock:** the pipelined array still slows from 297 to 221 MHz between N = 2 and N = 15, from a path not yet identified. Instantiating the DSP48E1 directly with its internal OPMODE register is a further option.
- **v3 is limited by the UART:** compute is about 1% of the time per frame. Next steps are a faster link (higher baud, then Ethernet), then double-buffered input so the next frame arrives while the current one computes, then a larger array.
- **Hand-drawn digits:** the 784 → 64 → 10 MLP reaches 97.2% on MNIST but misreads some mouse-drawn digits. Training with augmentation (shifts, rotations, stroke width) or a larger hidden layer would help without changing the RTL.
- **v3 is fixed to this network and N = 4:** the 4-byte word packing assumes N = 4 (the word is 8×N bits), and the layer sizes come from `model_params.svh`.
- **UART speed:** a stream from a PC whose clock runs fast can eventually outrun the transmitter (a slower sender cannot keep up forever); jobs avoid it because the host waits for each reply. A small FIFO would cover long streams.

## AI use

- **Design (RTL):** all design files in `rtl/` were written by me. Claude reviewed them, explained concepts and pointed out bugs, which I then fixed. The OPMODE fix (zeroing invalid products) and the `keep` attribute came out of analysing the Vivado timing reports with Claude; I implemented both.
- **Board RTL:** `uart_rx`, `uart_tx`, `board_top`, `sa_board_top` and `sa_ctrl` were written by me (for `sa_ctrl` from a state-machine template), with Claude reviewing each version and pointing out bugs. The Wukong pin constraints were taken from the QMTECH V3 schematic with Claude.
- **Testbenches:** `tb_mac`, `tb_skew` and `tb_pe` were written by me, and review by Claude. The others (`tb_sa2x2`, `tb_asNxN`, `tb_sa_top` and the UART, board and controller testbenches) were generated with Claude and run against my designs; I am rewriting them one by one.
- **v3 RTL:** `frame_rx`, `infer_core`, `reply_tx`, `infer_board_top`, `requant`, `argmax`, `simple_dp_ram` and `weight_rom` were written by me. Claude reviewed each version and pointed out where it was wrong, and I fixed and reimplemented it until it passed the testbenches.
- **v3 testbenches and tools:** all v3 testbenches, `tb/gen_requant_vectors.py`, `tb/gen_infer_vectors.py`, `ml/gen_mem.py`, `host/infer_frame.py` with its tests, `board_infer.py --onchip` and the drawing demo `ml/draw_demo.py` were written by Claude.
- **Host and CI:** `host/run_jobs.py` was written by me with Claude reviewing it. `sim/run_all.sh` and the GitHub Actions workflow were written by Claude.
- **Synthesis:** the Yosys/nextpnr script, the measurement harness and the Vivado sweep script in `synth/` were written by Claude. The Vivado runs were set up and run by me.
- **Documentation:** this README was drafted with Claude.

## Tools

- SystemVerilog (IEEE 1800-2012)
- Icarus Verilog 12 for simulation
- sv2v, Yosys and nextpnr for open-source synthesis and place and route (Lattice ECP5)
- AMD Vivado 2025.2 (board builds) and 2026.1 (synthesis sweeps) (Artix-7)
- Python 3 with NumPy and pyserial for the host script
- GitHub Actions (Icarus Verilog 12 from Ubuntu) for continuous integration
