ducdung3907/ai-rtl/docs/board.jpg

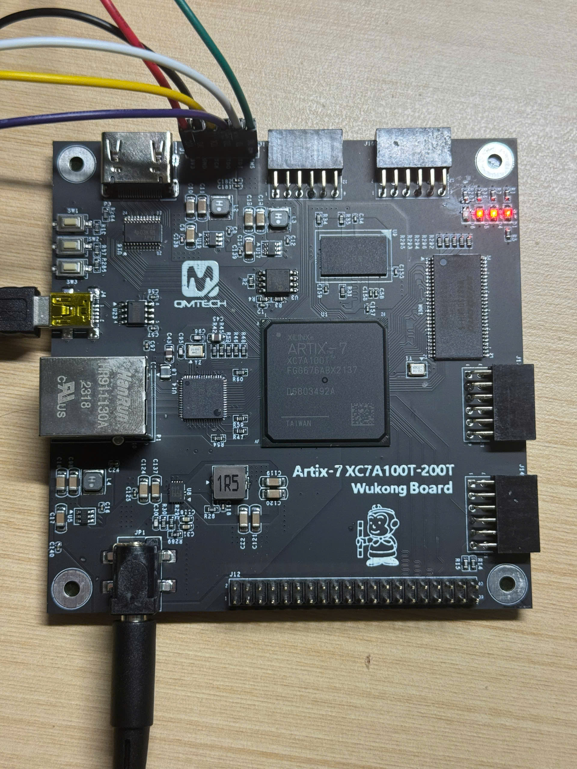
docs/board.jpg
