ducdung3907/ai-rtl/synth/results_mac1.csv

mac_lat | N | PEs | generic_cells | generic_ffs | ecp5_luts | ecp5_ffs | ecp5_mult18 | fmax_mhz
1 | 2 | 4 | 3325 | 183 | 375 | 265 | 4 | 96.33
1 | 4 | 16 | 13482 | 819 | 1259 | 761 | 16 | 82.85
1 | 8 | 64 | 53675 | 3435 | 5235 | 2521 | 64 | 61.46
1 | 12 | 144 | 121013 | 7843 | 11483 | 5305 | 144 | 48.30
