ducdung3907/ai-rtl/synth/results_mac2.csv

mac_lat | N | PEs | generic_cells | generic_ffs | ecp5_luts | ecp5_ffs | ecp5_mult18 | fmax_mhz
2 | 2 | 4 | 3281 | 254 | 375 | 336 | 4 | 139.94
2 | 4 | 16 | 13257 | 1090 | 1260 | 1033 | 16 | 117.36
2 | 8 | 64 | 53008 | 4490 | 5236 | 3577 | 64 | 93.35
