ducdung3907/ai-rtl/synth/results_vivado_mac2_before.csv

mac_lat | N | PEs | luts | lutram | ffs | dsps | wns_ns | fmax_mhz | power_w | status
2 | 2 | 4 | 5 | 0 | 14 | 4 | 0.592 | 226.9 | 0.092 | ok
2 | 4 | 16 | 9 | 0 | 194 | 16 | 0.525 | 223.5 | 0.123 | ok
2 | 8 | 64 | 41 | 24 | 1018 | 64 | 0.358 | 215.4 | 0.247 | ok
2 | 12 | 144 | 82 | 56 | 2338 | 144 | 0.091 | 203.7 | 0.452 | ok
2 | 15 | 225 | 119 | 80 | 3664 | 225 | 0.065 | 202.6 | 0.663 | ok
2 | 16 | 256 | 1691 | 88 | 5244 | 240 | -0.192 | 192.6 | 0.757 | ok
