ducdung3907/ai-rtl/synth/results_vivado_mac2_keep.csv

mac_lat | N | PEs | luts | lutram | ffs | dsps | wns_ns | fmax_mhz | power_w | status
2 | 2 | 4 | 6 | 0 | 12 | 4 | 1.633 | 297 | 0.092 | ok
2 | 4 | 16 | 11 | 0 | 196 | 16 | 1.45 | 281.7 | 0.12 | ok
2 | 8 | 64 | 47 | 24 | 1052 | 64 | 1.094 | 256 | 0.237 | ok
2 | 12 | 144 | 102 | 56 | 2436 | 144 | 0.704 | 232.8 | 0.43 | ok
2 | 15 | 225 | 147 | 80 | 3831 | 225 | 0.473 | 220.9 | 0.631 | ok
2 | 16 | 256 | 1685 | 88 | 5400 | 240 | -0.29 | 189 | 0.712 | ok
