ducdung3907/ai-rtl/synth/results_vivado_mac2_opmodefix.csv

mac_lat | N | PEs | luts | lutram | ffs | dsps | wns_ns | fmax_mhz | power_w | status
2 | 2 | 4 | 7 | 0 | 11 | 4 | 1.495 | 285.3 | 0.092 | ok
2 | 4 | 16 | 13 | 0 | 187 | 16 | 1.226 | 265 | 0.12 | ok
2 | 8 | 64 | 50 | 24 | 1003 | 64 | 0.677 | 231.3 | 0.238 | ok
2 | 12 | 144 | 105 | 56 | 2315 | 144 | 0.487 | 221.6 | 0.436 | ok
2 | 15 | 225 | 145 | 80 | 3653 | 225 | 0.412 | 218 | 0.638 | ok
2 | 16 | 256 | 1687 | 88 | 5214 | 240 | -0.181 | 193 | 0.713 | ok
