ducdung3907/ai-rtl/rtl/mac.sv

module mac8 (
    input logic clk,
    input logic rst_n,

    input logic signed [7:0] a,
    input logic signed [7:0] b,

    input logic valid_in,
    input logic clear,

    output logic signed [31:0] acc
);

    logic signed [31:0] next_acc;

    always_comb begin
        next_acc = acc;
        if (clear&&valid_in) begin
            next_acc = a*b;
        end else if (clear) begin
            next_acc = '0;
        end else if (valid_in) begin
            next_acc = acc + a*b;
        end
    end

    always_ff @(posedge clk or negedge rst_n) begin
        if (!rst_n) begin
            acc <= '0;
        end else begin
            acc <= next_acc;
        end
    end

endmodule

(* use_dsp = "yes" *)
module mac8_pipe (
    input logic clk,
    input logic rst_n,

    input logic signed [7:0] a,
    input logic signed [7:0] b,

    input logic valid_in,
    input logic clear,

    output logic signed [31:0] acc
);

    logic signed [15:0] prod;
    (* keep = "true" *) logic clear1;

    always_ff @(posedge clk) begin
        if ((!valid_in)||(!rst_n)) begin
            prod <= 0;
        end else begin
            prod <= a*b;
        end
    end

    always_ff @(posedge clk) begin
        if (!rst_n) begin
            clear1 <= 1'b0;
        end else begin
            clear1<= clear;
        end
    end

    always_ff @(posedge clk) begin
        if (!rst_n) begin
            acc <= '0;
        end else if (clear1) begin
            acc <= prod;
        end else begin
            acc <= acc + prod;
        end
    end

endmodule
