ducdung3907/ai-rtl/(commit log)

2026-10-23 add synthesis result for N = 2 4 8, using yosys and nextpnr
    [results.csv]
2026-10-24 Port clean up and pipelined implementation with synchronous reset
    [mac.sv, pe.sv, sa_top.sv]
2026-10-24 fixing bug related to pipelined implementation
    [results.csv]
2026-10-24 add result for synthesis with yosys
    [results.csv, results_mac1.csv, results_mac2.csv]
2026-10-25 add synth result by yosys and npr
    [results_mac1.csv, results_mac2.csv]
2026-10-25 add result before opmode fix
    [results_vivado_mac2_before.csv]
2026-10-25 add the result after opmode fix
    [results_vivado_mac2_opmodefix.csv]
2026-10-25 Add keep on clear1, Vivado results after keep, README v1
    [results_vivado_mac2_keep.csv]
2026-10-27 Rewrite tb_mac to test both MACs
    Self-written testbench checking mac8 and mac8_pipe side by side against one
    reference model (mac8_pipe compared one cycle later).
    - Reset test with inputs active during reset
    - Directed tests: signs, zero operand, hold, clear with and without valid,
    extreme products (-128*-128, -128*127)
    - Weighted random test (20,000 cycles, seedable with +seed=N) with
    coverage counters for clear+valid and -128*-128
    - Passes with seeds 1, 7, 99, 1234, 2026; catches injected bugs in both MACs
    [tb_mac.sv]
2026-10-29 tb_skew: rewrite by hand
    Input-history model (lane i = input from i cycles ago), reset test
    with inputs active, impulse, counting table, toggle and 2,000-cycle
    weighted random tests. Passes for N = 1-16; catches wrong data
    delay, missing valid reset and a missing lane.
    [tb_skew.sv]
2026-10-29 uart_tx: 8N1 transmitter with valid/ready handshake
    Parameterised CLK_HZ/BAUD with rounded clocks-per-bit, registered tx,
    idle-high reset. Testbench decodes frames with a receiver model and a
    queue scoreboard; passes 316 bytes (directed, back-to-back, random).
    [tb_uart_tx.sv, uart_tx.sv]
2026-10-29 uart_rx: 8N1 receiver with 2-flop synchroniser
    Mid-bit sampling, false-start (glitch) rejection, framing-error drop,
    one-clock valid pulse. Testbench: async sender with +/-2.5% baud error,
    glitches, bad stop bits, back-to-back and random bytes; 238/238 bytes.
    [tb_uart_rx.sv, uart_rx.sv]
2026-10-30 Add pin configuration
2026-10-30 attempt to write boardtop
2026-10-30 add boardtop.sv
2026-10-30 board_top: UART echo for Wukong V3, back-to-back TX
    uart_tx accepts the next byte in the last stop-bit clock, so frames
    follow with no gap (fixes every other byte being dropped in echo).
    board_top: reset synchroniser, RX->TX echo, heartbeat and byte LEDs
    (active low). wukong.xdc pins from the QMTECH V3 schematic.
    [tb_board_top.sv, tb_uart_tx.sv, uart_tx.sv]
2026-10-30 add fix to warning in synthesis
    [uart_rx.sv, wukong.xdc]
2026-10-30 pin voltage
2026-11-01 board_top: pending flag between uart_rx and uart_tx
    rx_valid sets pending, the TX handshake clears it, so a byte waits for
    ready instead of being lost. Parameters moved to the #() header, heartbeat
    width from CLK_HZ. tb_board_top: PC_SPEED, N_BYTES, GAPS parameters;
    passes continuous streams at PC +/-0.5%.
2026-11-01 saved board_top.sv
2026-11-01 sa_ctrl: UART job controller for complete_sa (2-byte K)
    0xA5 header, K little-endian (K=0 ignored), 2N bytes per step, one valid
    pulse per step with start/last, acc snapshot on done, 4*N*N reply bytes
    little-endian on the tx handshake. tb_sa_ctrl: real complete_sa, K = 0, 1,
    N, 7, 256 and random, tx_ready backpressure; passes N = 2, 4, 8.
2026-11-02 sa_board_top: UART -> sa_ctrl -> complete_sa on the Wukong pins
    Reset synchroniser, heartbeat LED, job-done LED toggle. System testbench
    sends jobs bit by bit into the uart_rx pin and checks C from the uart_tx
    pin; passes N = 2/4, MAC_LAT = 1/2, PC +/-0.5% baud.
    [sa_board_top.sv, tb_sa_board_top.sv]
2026-11-02 make_job (random int8 A, B), build_job (A5 + K little-endian + K steps of column-of-A / row-of-B), parse_reply (4N² bytes → N×N int32), run_job (send, read, compare with NumPy A @ B)
2026-11-02 README: board interface, host script, updated verification, CI badge, AI use
2026-11-03 change readme and update the board img
2026-11-03 sync_fifo: FWFT byte FIFO with sticky overflow
    Push accepted when full if a pop happens in the same cycle; memory in a
    reset-free block for LUTRAM/BRAM inference. Queue-model testbench checks
    every output each cycle; passes DEPTH = 1, 5, 16.
    [sync_fifo.sv]
2026-11-05 ml algo and on board
2026-11-05 v2 replaces v1: sa_ctrl, sa_board_top and their testbenches
    [tb_sa_board_top.sv, tb_sa_ctrl.sv]
2026-11-06 requant on board
2026-11-06 pc to fpga protocol for frame transfer
2026-11-08 v3: reply_tx and infer_board_top (on-chip MNIST board)
    - reply_tx: builds [A6][seq][d0..d3] on done and [E6][seq] on a checksum
    error; done wins if both arrive together, events during a reply are
    dropped. Shift register + byte counter, valid/ready to uart_tx.
    - infer_board_top: uart_rx -> frame_rx -> infer_core -> reply_tx -> uart_tx.
    Same pins as sa_board_top (wukong.xdc unchanged). led[0] heartbeat,
    led[1] toggles once per reply.
    - tb_reply_tx: random done/err, both at once, events while busy,
    ready 100/50/10%.
    - tb_infer_board_top: whole chain through the UART pins (junk, good frames,
    bad checksum, cut frames, seq 0/127, LEDs).
    - run_all.sh: reply_tx and infer_board_top runs.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
    [infer_board_top.sv, tb_infer_board_top.sv]
2026-11-08 frame_rx: avoid ?: on an enum (newer Icarus in CI requires a cast)
    [frame_rx.sv]
